AA-CubeSat-Team/soci_eps/README.md

# soci_eps

This is a repo for the EPS (electrical power system) subsystem of SOC-I.
