AA-CubeSat-Team/soci_eps/EAGLE/Projects/EPS Flatsat Module/EPS Flatsat Module/EPS Flatsat Module2.brd

## EAGLE design EAGLE/Projects/EPS Flatsat Module/EPS Flatsat Module/EPS Flatsat Module2.brd (2021-05-12)

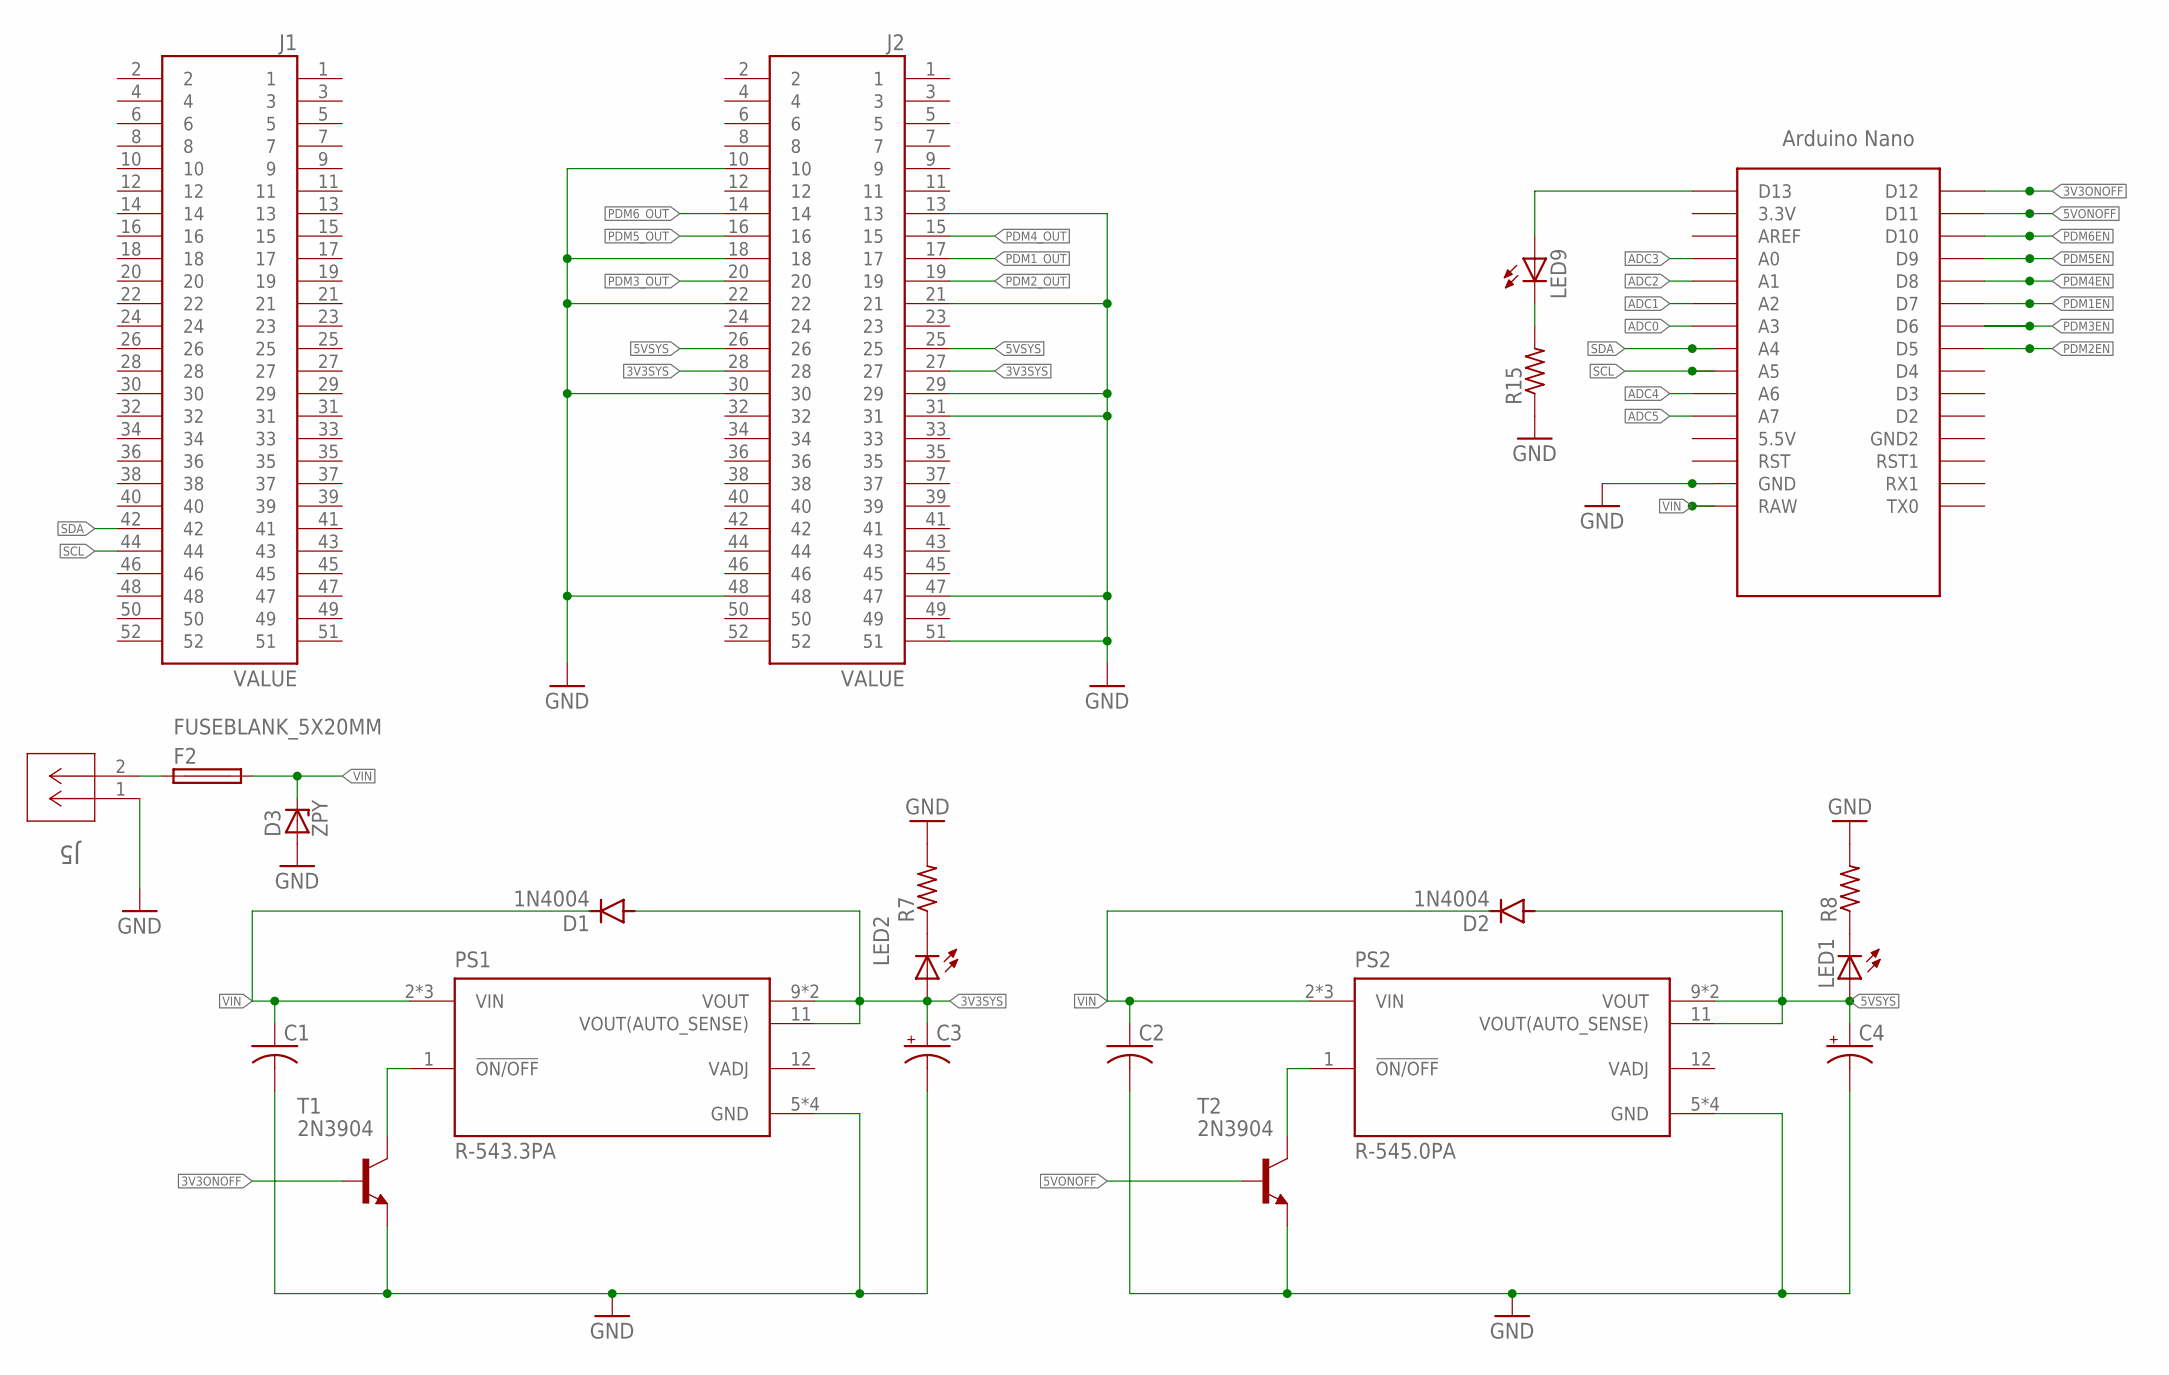
[picture p1: schematic EPS Flatsat Module2.sch, sheet 1]

Parts:
C1, C2: C-USC0805; C0805
C3, C4: CPOL-USE2.5-6; E2,5-6
D1, D2: 1N4004; DO41-10
D3: ZPY; DO41Z10
F2: FUSEBLANK_5X20MM; FUSE_HOLDER_5X20MM
J1, J2: ESQ-126-39-G-D; SAMTEC_ESQ-126-39-G-D
J5: 1985881; CONN_1715022_PXC
LED1, LED2: LEDCHIPLED_0805; CHIPLED_0805
LED9: LEDCHIP-LED0805; CHIP-LED0805
PS1: R-543.3PA; CONV_R-543.3PA
PS2: R-545.0PA; CONV_R-545.0PA
R7, R8, R15: R-US_R0805; R0805
T1, T2: 2N3904; TO92
U$1: NANO

Connections:
3V3ONOFF: T1.2 (B), U$1.D12
3V3SYS: C3.+, D1.A, J2.27, J2.28, LED2.A, PS1.9 (VOUT), PS1.10 (VOUT), PS1.11 (VOUT(AUTO_SENSE)); also elsewhere on the board
5VONOFF: T2.2 (B), U$1.D11
5VSYS: C4.+, D2.A, J2.25, J2.26, LED1.A, PS2.9 (VOUT), PS2.10 (VOUT), PS2.11 (VOUT(AUTO_SENSE)); also elsewhere on the board
ADC0: U$1.A3; also elsewhere on the board
ADC1: U$1.A2; also elsewhere on the board
ADC2: U$1.A1; also elsewhere on the board
ADC3: U$1.A0; also elsewhere on the board
ADC4: U$1.A6; also elsewhere on the board
ADC5: U$1.A7; also elsewhere on the board
GND: C1.2, C2.2, C3.-, C4.-, D3.A, J2.10, J2.13, J2.18, J2.21, J2.22, J2.29, J2.30, J2.31, J2.47, J2.48, J2.51, J5.1, PS1.5 (GND), PS1.6 (GND), PS1.7 (GND), PS1.8 (GND), PS2.5 (GND), PS2.6 (GND), PS2.7 (GND), PS2.8 (GND), R7.2, R8.2, R15.1, T1.3 (E), T2.3 (E), U$1.GND; also elsewhere on the board
unnamed: PS1.1 (!ON/OFF), T1.1 (C)
unnamed: PS2.1 (!ON/OFF), T2.1 (C)
unnamed: LED1.C, R8.1
unnamed: LED2.C, R7.1
unnamed: F2.1, J5.2
unnamed: LED9.A, U$1.D13
unnamed: LED9.C, R15.2
PDM1EN: U$1.D7; also elsewhere on the board
PDM1_OUT: J2.17; also elsewhere on the board
PDM2EN: U$1.D5; also elsewhere on the board
PDM2_OUT: J2.19; also elsewhere on the board
PDM3EN: U$1.D6; also elsewhere on the board
PDM3_OUT: J2.20; also elsewhere on the board
PDM4EN: U$1.D8; also elsewhere on the board
PDM4_OUT: J2.15; also elsewhere on the board
PDM5EN: U$1.D9; also elsewhere on the board
PDM5_OUT: J2.16; also elsewhere on the board
PDM6EN: U$1.D10; also elsewhere on the board
PDM6_OUT: J2.14; also elsewhere on the board
SCL: J1.44, U$1.A5
SDA: J1.42, U$1.A4
VIN: C1.1, C2.1, D1.C, D2.C, D3.C, F2.2, PS1.2 (VIN), PS1.3 (VIN), PS1.4 (VIN), PS2.2 (VIN), PS2.3 (VIN), PS2.4 (VIN), U$1.RAW

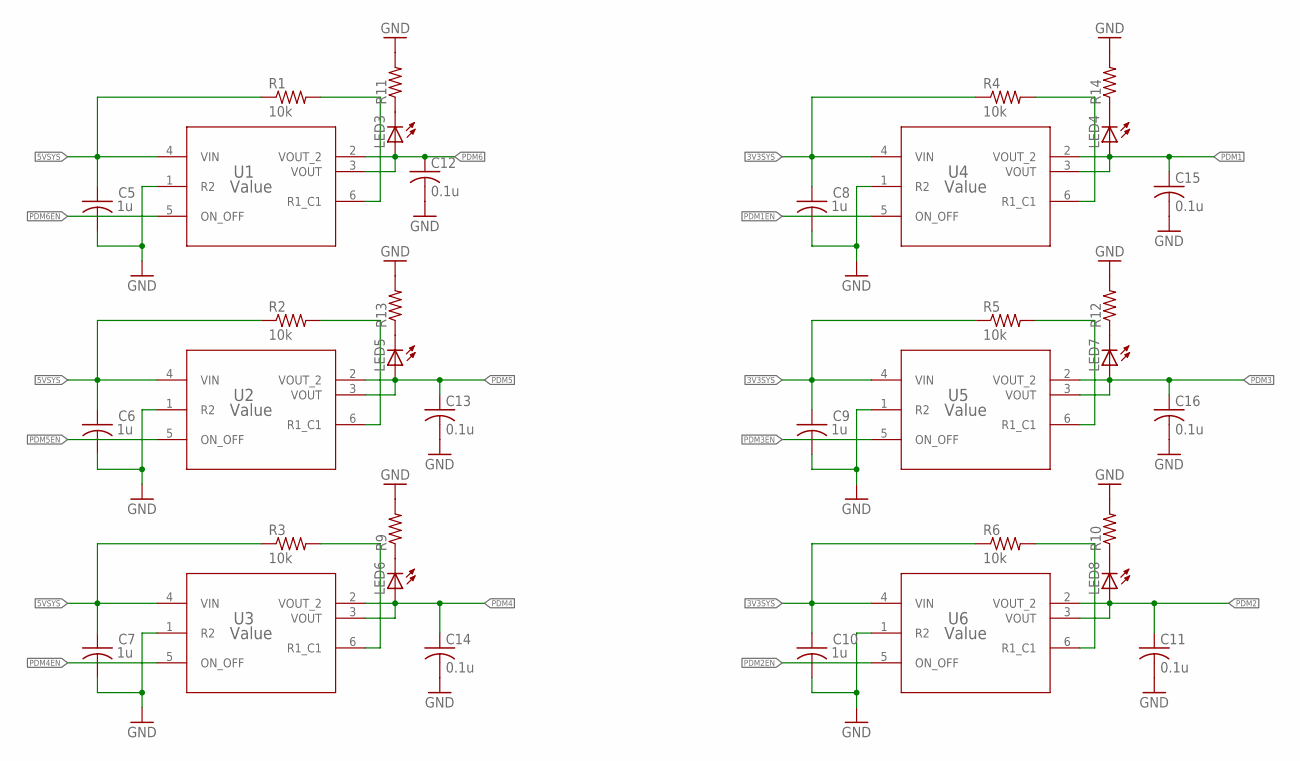
[picture p2: schematic EPS Flatsat Module2.sch, sheet 2]

Parts:
C5, C6, C7, C8, C9, C10: 1u; C0805
C11, C12, C13, C14, C15, C16: 0.1u; C0805
LED3, LED4, LED5, LED6, LED7, LED8: LEDCHIPLED_0805; CHIPLED_0805
R1, R2, R3, R4, R5, R6: 10k; R0805
R9, R10, R11, R12, R13, R14: R-US_R0805; R0805
U1, U2, U3, U4, U5, U6: Value; DDC0006A_N

Connections:
3V3SYS: C8.1, C9.1, C10.1, R4.1, R5.1, R6.1, U4.4 (VIN), U5.4 (VIN), U6.4 (VIN); also elsewhere on the board
5VSYS: C5.1, C6.1, C7.1, R1.1, R2.1, R3.1, U1.4 (VIN), U2.4 (VIN), U3.4 (VIN); also elsewhere on the board
GND: C5.2, C6.2, C7.2, C8.2, C9.2, C10.2, C11.2, C12.2, C13.2, C14.2, C15.2, C16.2, R9.2, R10.2, R11.2, R12.2, R13.2, R14.2, U1.1 (R2), U2.1 (R2), U3.1 (R2), U4.1 (R2), U5.1 (R2), U6.1 (R2); also elsewhere on the board
unnamed: R1.2, U1.6 (R1_C1)
unnamed: R2.2, U2.6 (R1_C1)
unnamed: R3.2, U3.6 (R1_C1)
unnamed: R4.2, U4.6 (R1_C1)
unnamed: R5.2, U5.6 (R1_C1)
unnamed: R6.2, U6.6 (R1_C1)
unnamed: LED6.C, R9.1
unnamed: LED3.C, R11.1
unnamed: LED4.C, R14.1
unnamed: LED7.C, R12.1
unnamed: LED5.C, R13.1
unnamed: LED8.C, R10.1
PDM1: C15.1, LED4.A, U4.2 (VOUT_2), U4.3 (VOUT); also elsewhere on the board
PDM1EN: U4.5 (ON_OFF); also elsewhere on the board
PDM2: C11.1, LED8.A, U6.2 (VOUT_2), U6.3 (VOUT); also elsewhere on the board
PDM2EN: U6.5 (ON_OFF); also elsewhere on the board
PDM3: C16.1, LED7.A, U5.2 (VOUT_2), U5.3 (VOUT); also elsewhere on the board
PDM3EN: U5.5 (ON_OFF); also elsewhere on the board
PDM4: C14.1, LED6.A, U3.2 (VOUT_2), U3.3 (VOUT); also elsewhere on the board
PDM4EN: U3.5 (ON_OFF); also elsewhere on the board
PDM5: C13.1, LED5.A, U2.2 (VOUT_2), U2.3 (VOUT); also elsewhere on the board
PDM5EN: U2.5 (ON_OFF); also elsewhere on the board
PDM6: C12.1, LED3.A, U1.2 (VOUT_2), U1.3 (VOUT); also elsewhere on the board
PDM6EN: U1.5 (ON_OFF); also elsewhere on the board

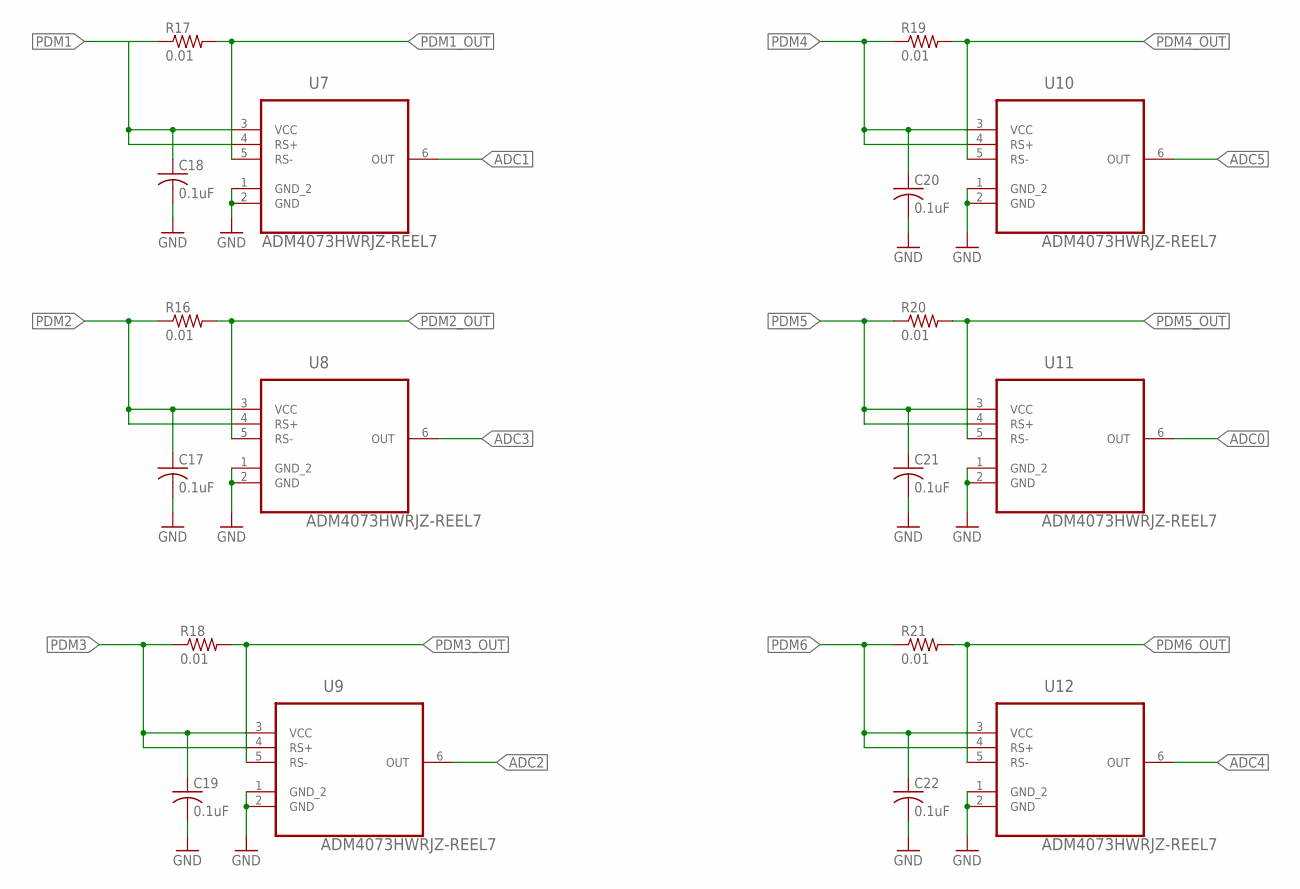
[picture p3: schematic EPS Flatsat Module2.sch, sheet 3]

Parts:
C17, C18, C19, C20, C21, C22: 0.1uF; C0805
R16, R17, R18, R19, R20, R21: 0.01; R2512
U7, U8, U9, U10, U11, U12: ADM4073HWRJZ-REEL7; SOT95P290X145-6N

Connections:
ADC0: U11.6 (OUT); also elsewhere on the board
ADC1: U7.6 (OUT); also elsewhere on the board
ADC2: U9.6 (OUT); also elsewhere on the board
ADC3: U8.6 (OUT); also elsewhere on the board
ADC4: U12.6 (OUT); also elsewhere on the board
ADC5: U10.6 (OUT); also elsewhere on the board
GND: C17.2, C18.2, C19.2, C20.2, C21.2, C22.2, U7.1 (GND_2), U7.2 (GND), U8.1 (GND_2), U8.2 (GND), U9.1 (GND_2), U9.2 (GND), U10.1 (GND_2), U10.2 (GND), U11.1 (GND_2), U11.2 (GND), U12.1 (GND_2), U12.2 (GND); also elsewhere on the board
PDM1: C18.1, R17.1, U7.3 (VCC), U7.4 (RS+); also elsewhere on the board
PDM1_OUT: R17.2, U7.5 (RS-); also elsewhere on the board
PDM2: C17.1, R16.1, U8.3 (VCC), U8.4 (RS+); also elsewhere on the board
PDM2_OUT: R16.2, U8.5 (RS-); also elsewhere on the board
PDM3: C19.1, R18.1, U9.3 (VCC), U9.4 (RS+); also elsewhere on the board
PDM3_OUT: R18.2, U9.5 (RS-); also elsewhere on the board
PDM4: C20.1, R19.1, U10.3 (VCC), U10.4 (RS+); also elsewhere on the board
PDM4_OUT: R19.2, U10.5 (RS-); also elsewhere on the board
PDM5: C21.1, R20.1, U11.3 (VCC), U11.4 (RS+); also elsewhere on the board
PDM5_OUT: R20.2, U11.5 (RS-); also elsewhere on the board
PDM6: C22.1, R21.1, U12.3 (VCC), U12.4 (RS+); also elsewhere on the board
PDM6_OUT: R21.2, U12.5 (RS-); also elsewhere on the board

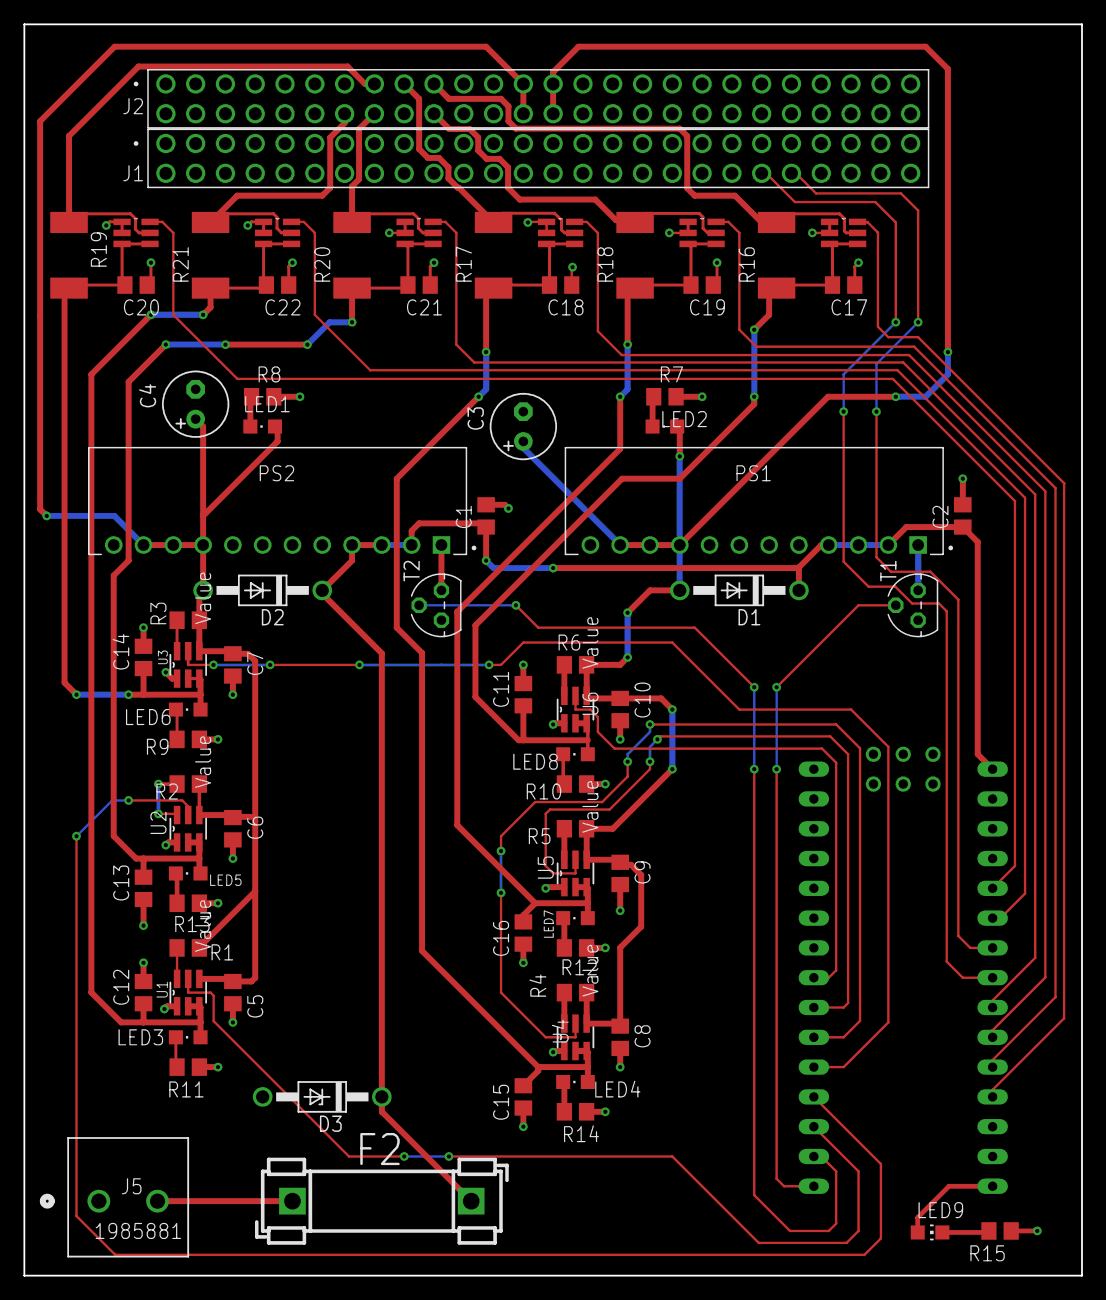
[picture p4: board EPS Flatsat Module2.brd from above]

Board: 2 copper layers, 90.2 x 106.7 mm, 76 parts (0 on the bottom side), 51 nets.
