AA-CubeSat-Team/soci_eps/EAGLE/Projects/EPS Flatsat Module/EPS Flatsat Module/EPS Flatsat Module.brd

## EAGLE design EAGLE/Projects/EPS Flatsat Module/EPS Flatsat Module/EPS Flatsat Module.brd (2020-06-23)

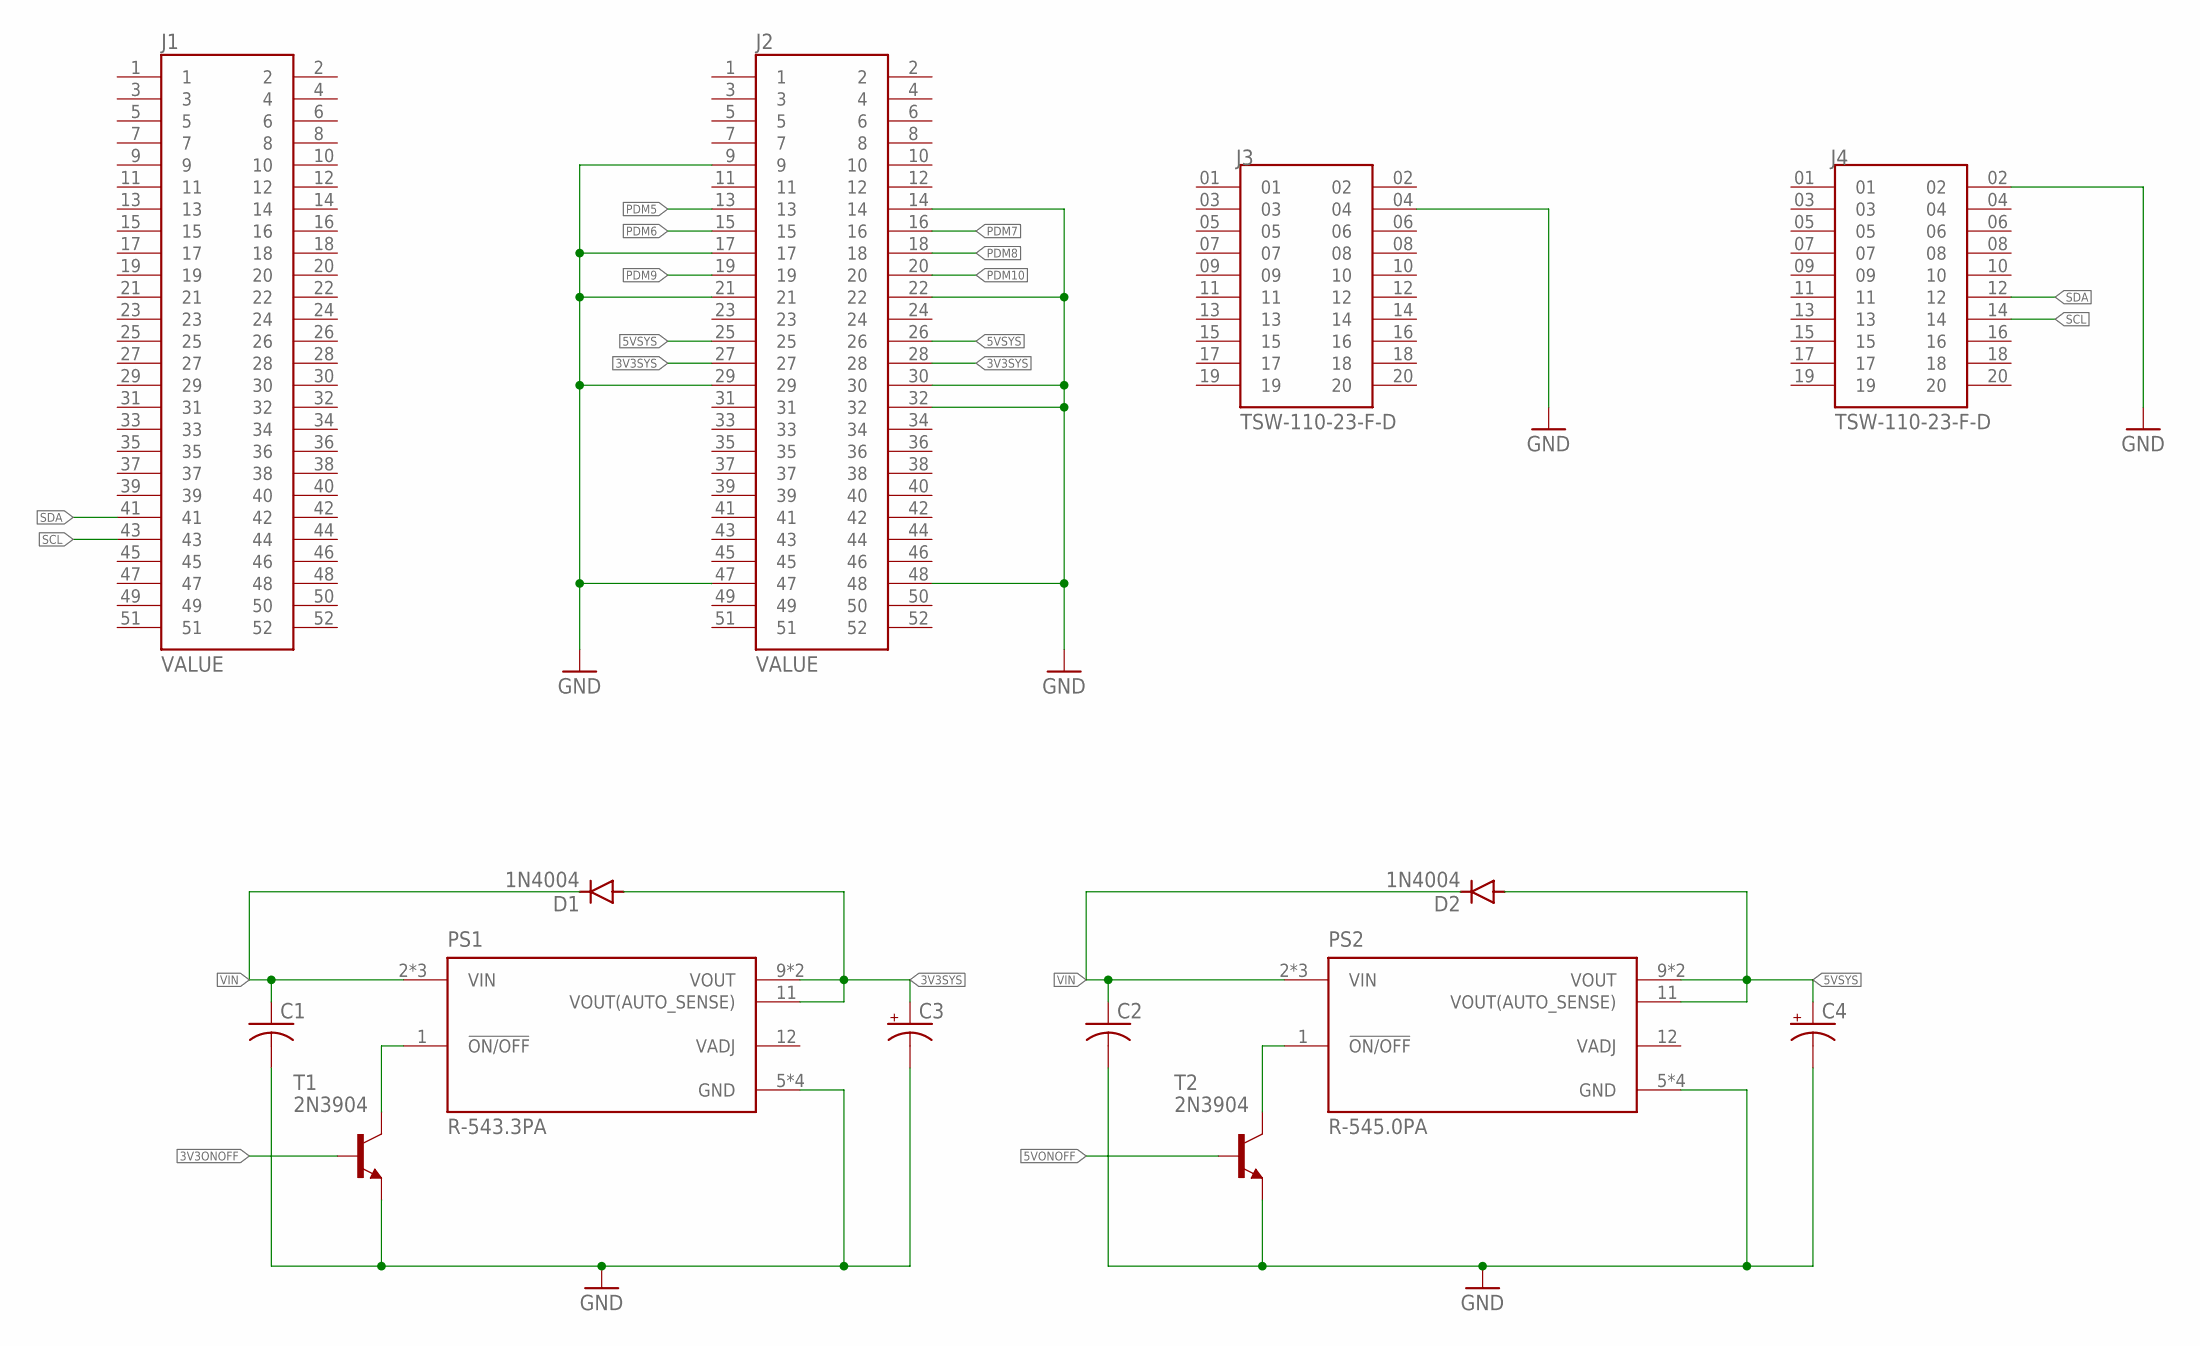
[picture p5: schematic EPS Flatsat Module.sch, sheet 1]

Parts:
C1, C2: C-USC0805; C0805
C3, C4: CPOL-USE2.5-6; E2,5-6
D1, D2: 1N4004; DO41-10
J1, J2: ESQ-126-39-G-D; SAMTEC_ESQ-126-39-G-D
J3, J4: TSW-110-23-F-D; SAMTEC_TSW-110-23-F-D
PS1: R-543.3PA; CONV_R-543.3PA
PS2: R-545.0PA; CONV_R-545.0PA
T1, T2: 2N3904; TO92

Connections:
3V3ONOFF: T1.2 (B)
3V3SYS: C3.+, D1.A, J2.27, J2.28, PS1.9 (VOUT), PS1.10 (VOUT), PS1.11 (VOUT(AUTO_SENSE)); also elsewhere on the board
5VONOFF: T2.2 (B)
5VSYS: C4.+, D2.A, J2.25, J2.26, PS2.9 (VOUT), PS2.10 (VOUT), PS2.11 (VOUT(AUTO_SENSE)); also elsewhere on the board
GND: C1.2, C2.2, C3.-, C4.-, J2.9, J2.14, J2.17, J2.21, J2.22, J2.29, J2.30, J2.32, J2.47, J2.48, J3.04, J4.02, PS1.5 (GND), PS1.6 (GND), PS1.7 (GND), PS1.8 (GND), PS2.5 (GND), PS2.6 (GND), PS2.7 (GND), PS2.8 (GND), T1.3 (E), T2.3 (E); also elsewhere on the board
unnamed: PS1.1 (!ON/OFF), T1.1 (C)
unnamed: PS2.1 (!ON/OFF), T2.1 (C)
PDM5: J2.13; also elsewhere on the board
PDM6: J2.15; also elsewhere on the board
PDM7: J2.16; also elsewhere on the board
PDM8: J2.18; also elsewhere on the board
PDM9: J2.19; also elsewhere on the board
PDM10: J2.20; also elsewhere on the board
SCL: J1.43, J4.14
SDA: J1.41, J4.12
VIN: C1.1, C2.1, D1.C, D2.C, PS1.2 (VIN), PS1.3 (VIN), PS1.4 (VIN), PS2.2 (VIN), PS2.3 (VIN), PS2.4 (VIN)

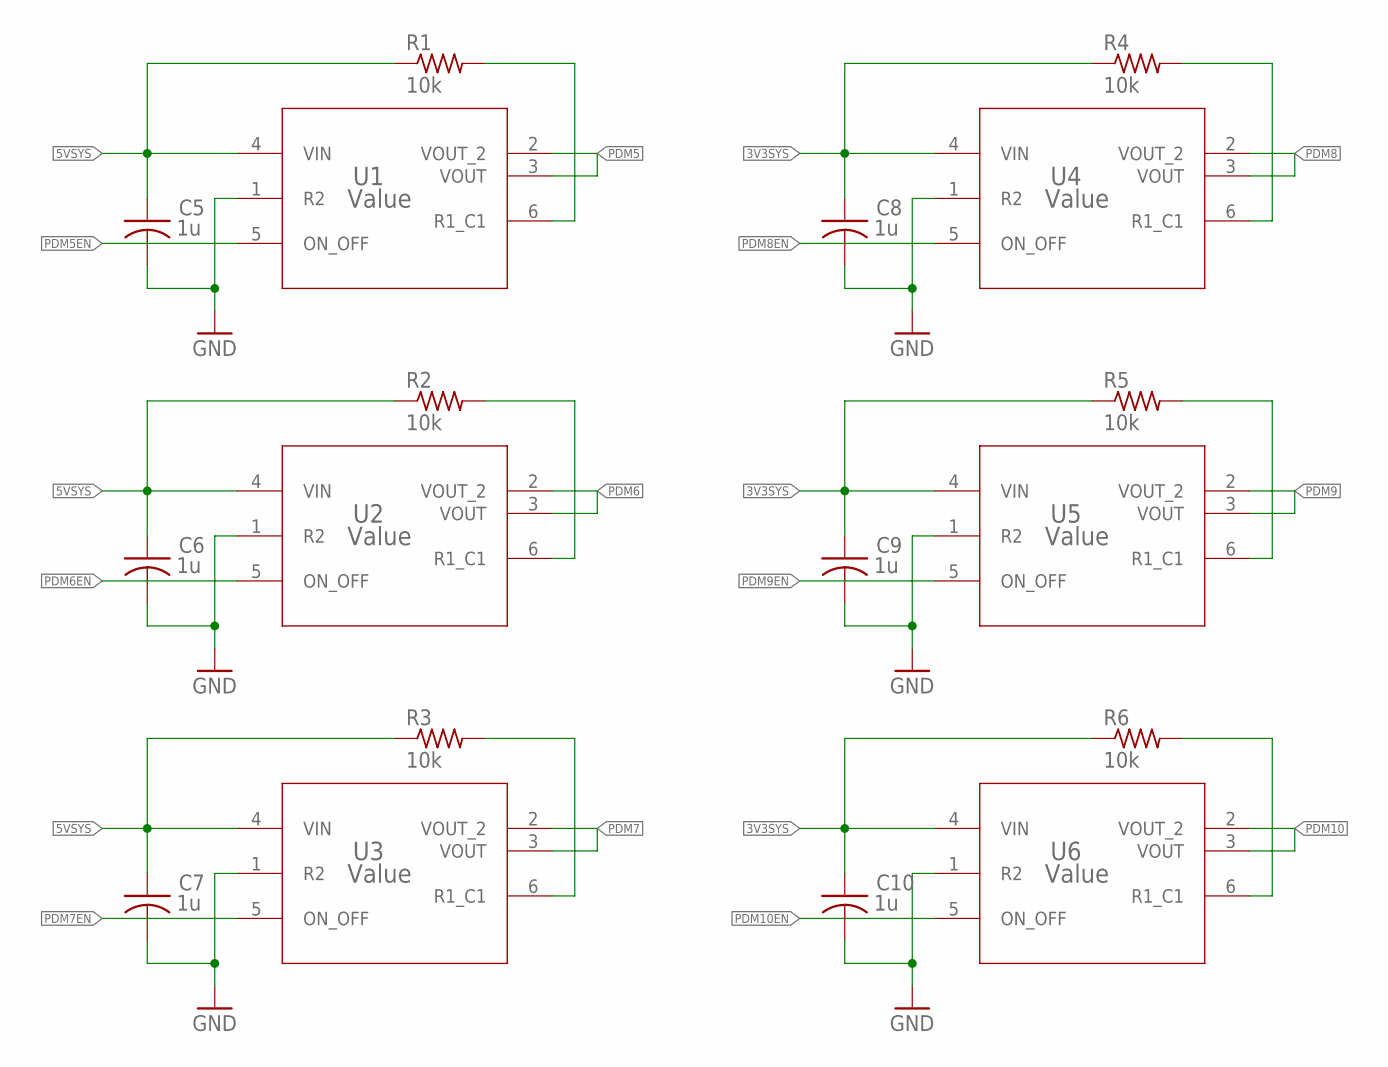
[picture p6: schematic EPS Flatsat Module.sch, sheet 2]

Parts:
C5, C6, C7, C8, C9, C10: 1u; C0805
R1, R2, R3, R4, R5, R6: 10k; R0805
U1, U2, U3, U4, U5, U6: Value; DDC0006A_N

Connections:
3V3SYS: C8.1, C9.1, C10.1, R4.1, R5.1, R6.1, U4.4 (VIN), U5.4 (VIN), U6.4 (VIN); also elsewhere on the board
5VSYS: C5.1, C6.1, C7.1, R1.1, R2.1, R3.1, U1.4 (VIN), U2.4 (VIN), U3.4 (VIN); also elsewhere on the board
GND: C5.2, C6.2, C7.2, C8.2, C9.2, C10.2, U1.1 (R2), U2.1 (R2), U3.1 (R2), U4.1 (R2), U5.1 (R2), U6.1 (R2); also elsewhere on the board
unnamed: R1.2, U1.6 (R1_C1)
unnamed: R2.2, U2.6 (R1_C1)
unnamed: R3.2, U3.6 (R1_C1)
unnamed: R4.2, U4.6 (R1_C1)
unnamed: R5.2, U5.6 (R1_C1)
unnamed: R6.2, U6.6 (R1_C1)
PDM5: U1.2 (VOUT_2), U1.3 (VOUT); also elsewhere on the board
PDM5EN: U1.5 (ON_OFF)
PDM6: U2.2 (VOUT_2), U2.3 (VOUT); also elsewhere on the board
PDM6EN: U2.5 (ON_OFF)
PDM7: U3.2 (VOUT_2), U3.3 (VOUT); also elsewhere on the board
PDM7EN: U3.5 (ON_OFF)
PDM8: U4.2 (VOUT_2), U4.3 (VOUT); also elsewhere on the board
PDM8EN: U4.5 (ON_OFF)
PDM9: U5.2 (VOUT_2), U5.3 (VOUT); also elsewhere on the board
PDM9EN: U5.5 (ON_OFF)
PDM10: U6.2 (VOUT_2), U6.3 (VOUT); also elsewhere on the board
PDM10EN: U6.5 (ON_OFF)

Board: 2 copper layers, 32 parts (0 on the bottom side), 20 nets, no tracks yet.
