AA-CubeSat-Team/soci_eps/EAGLE/Projects/RTC/rtc test board/rtc test board.brd

## EAGLE design EAGLE/Projects/RTC/rtc test board/rtc test board.brd (2020-04-15)

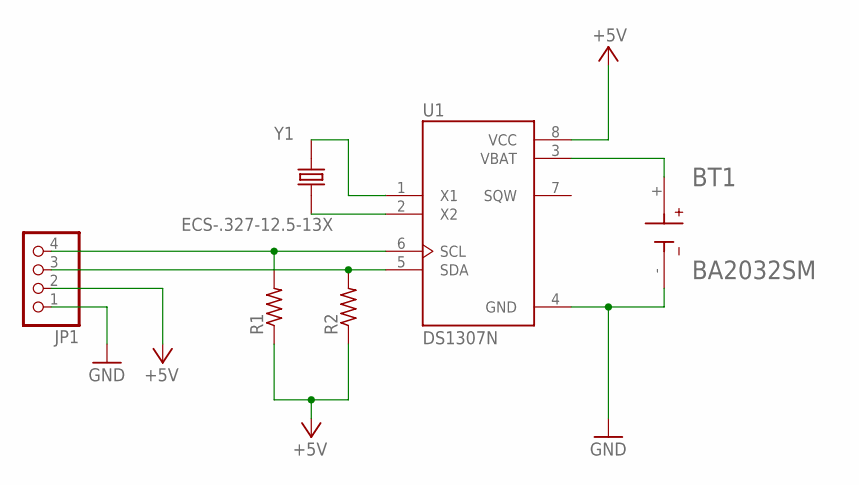
[picture p7: schematic rtc test board.sch]

Parts:
BT1: BA2032SM; BAT_BA2032SM
JP1: PINHD-1X4; 1X04
R1, R2: R-US_R0805; R0805
U1: DS1307N; DIP762W47P254L991H457Q8
Y1: ECS-.327-12.5-13X; XTAL_ECS-.327-12.5-13X

Connections:
+5V: JP1.2, R1.1, R2.1, U1.8 (VCC)
GND: BT1.-, JP1.1, U1.4 (GND)
unnamed: U1.2 (X2), Y1.2
unnamed: U1.1 (X1), Y1.1
unnamed: JP1.4, R1.2, U1.6 (SCL)
unnamed: JP1.3, R2.2, U1.5 (SDA)
unnamed: BT1.+, U1.3 (VBAT)

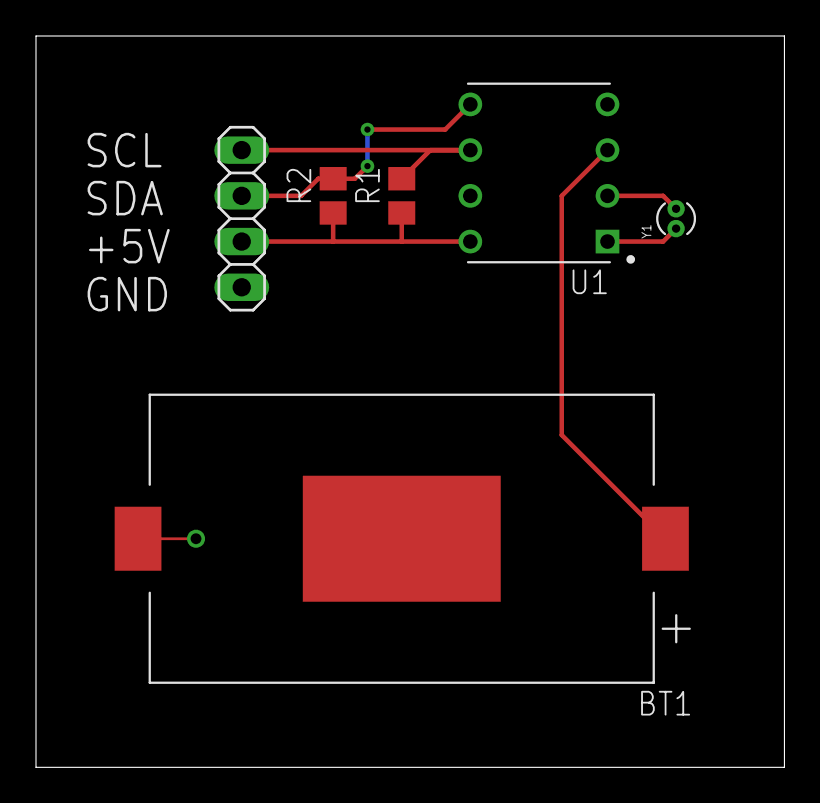
[picture p8: board rtc test board.brd from above]

Board: 2 copper layers, 41.6 x 40.6 mm, 6 parts (0 on the bottom side), 7 nets.
