AA-CubeSat-Team/soci_eps/(commit log)

2020-04-15 Added directory for eagle projects and libraries. Added RTC project and associated libraries.
    [rtc test board.brd, rtc test board.sch]
2020-04-15 Added CCS project with test code for RTC circuit, tested using MSP430
2020-04-28 Added power simulation
2020-04-28 Added power sim
2020-05-22 Created EAGLE project for flatsat module
    [EPS Flatsat Module.brd, EPS Flatsat Module.sch, rtc test board.brd, rtc test board.sch]
2020-06-23 small updates to power sim
2020-06-23 Updates to flatsat module. Added MSP430 headers, DCDC converters, and some power switches to schematic. Did some placement on the board layout.
    [EPS Flatsat Module.brd, EPS Flatsat Module.sch]
2020-06-23 Created flight software directory, which includes soci_cdh_drivers as a git submodule. Started on a template for the drivers that the OBC will need to communicate with EPS via i2c
2020-07-07 small updates to power sim, and added script to compute power after running sim
2020-07-07 Updated power model. Switched to using most recent dev branch of soci-gnc
2020-07-09 Updated script to compute power budget
2020-07-17 Updated power module. Added flags in matlab script to enable subsystems, and updated analyze script to run through multiple simulations
2020-07-30 created batt voltage function
2020-08-25 Updated flatsat module schematic/board
    [EPS Flatsat Module2.brd, EPS Flatsat Module2.sch]
2020-09-03 Updated fuse, changed MSP header spacing, small layout edits
    [EPS Flatsat Module2.brd, EPS Flatsat Module2.sch]
2020-10-15 Small updates to get power sim working. Updated script to compute average power of each subsystem and save them to a file
2020-10-26 Added TVS diode, changed microcontroller to Arduino Nano, redid traces
    [EPS Flatsat Module2.brd, EPS Flatsat Module2.sch]
2020-10-28 Update to board layout
    [EPS Flatsat Module2.brd]
2021-03-04 telemetry needs check and suggested corrections are fixed
    [eps_wrap.c]
2021-03-08 changes in description
    adc_count is returned in bat module stat and power mod stat. Old telemetry is moved over to dif file (inside old eps file)
2021-03-10 fixed header and fixed eps
    [eps_wrap.c]
2021-03-23 Add current sense fucntionality
2021-05-11 Added current sensing
    [EPS Flatsat Module2.brd, EPS Flatsat Module2.sch]
2021-05-19 Create controller for Flatsat EPS arduino
