AA-CubeSat-Team/soci_eps/(notices)

Notices in the files:
parts and their libraries:
1985881: COPYRIGHT: Copyright (C) 2018 Accelerated Designs. All rights reserved
